Annaest/legWheel_Robot/solidworks/总装.SLDASM

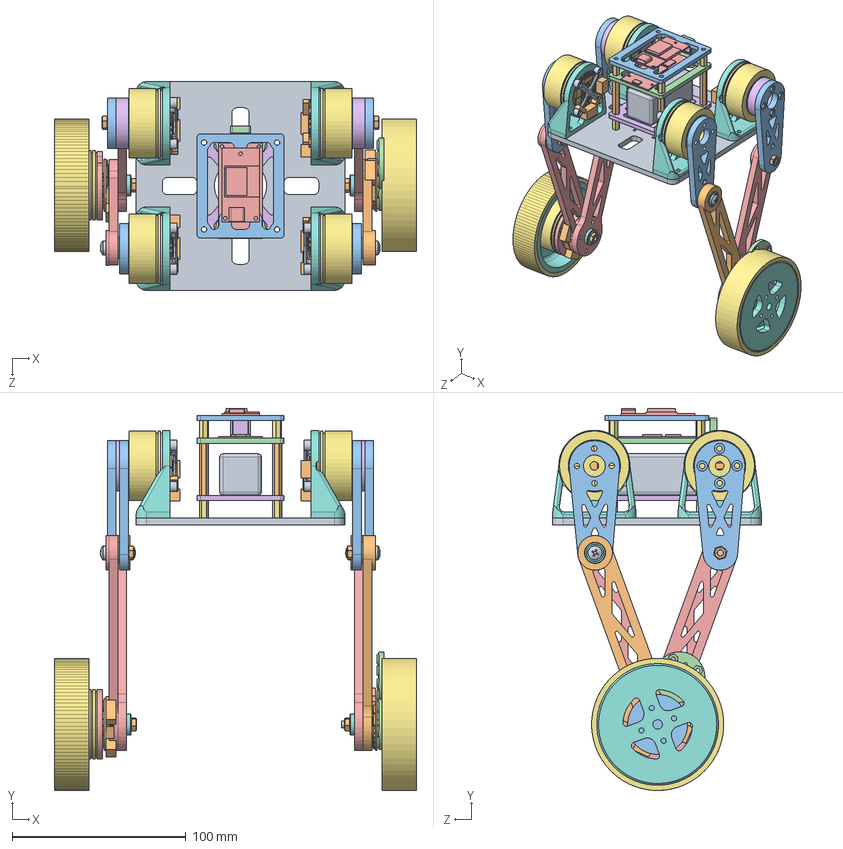
[picture p11: CAD file, 2024-07-02]
solidworks/总装.SLDASM
208.2 x 219.6 x 120.0 mm
底板
驱动板 x 6
大腿 x 4
推力轴承 x 6
小腿 x 3
大腿垫高 x 2
MISUMI_C-SE604ZZ_不锈钢小径滚珠轴承 x 6
cross recessed pan head screws gb x 4
hex nuts, style 1-grades ab gb x 6
编码器磁铁
MISUMI_CBSTSR4-16_内六角螺栓（盖螺栓）
主控板PCB
电池架
电池支撑铜柱 x 8
车轮 x 2
动力锂电池
主控支撑铜柱 x 4
主控支架
NanoPi支架
NanoPi
OV5640镜头
ME4010 x 5
关节电机支架-改 x 4
关节PCB紧固 x 3
小腿1
2805垫圈
轮胎 x 2
