Annaest/legWheel_Robot/solidworks/打印件/NanoPi支架.STL

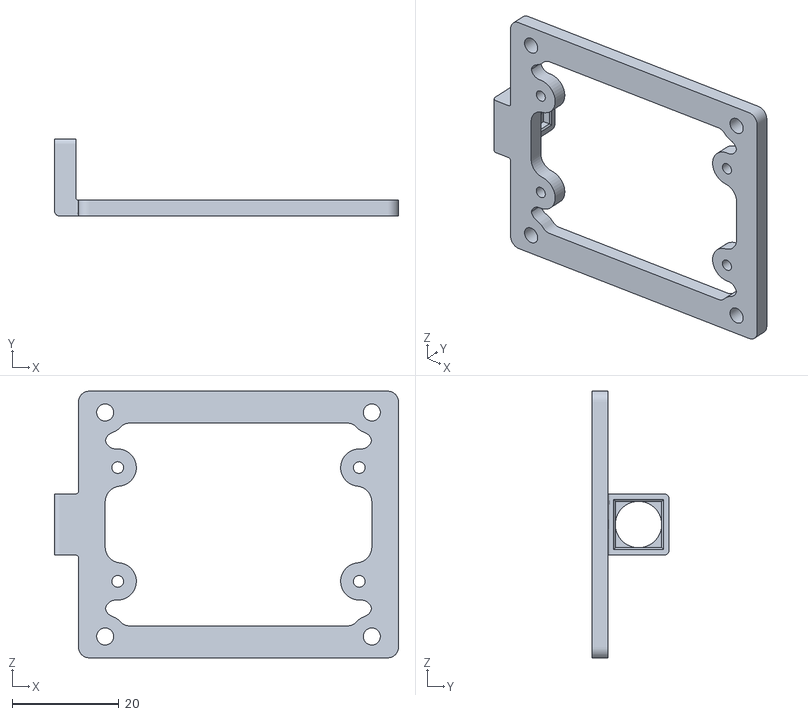
[picture p12: CAD file, 2024-07-02]
solidworks/打印件/NanoPi支架.STL
64.5 x 14.5 x 50.0
