Annaest/legWheel_Robot/solidworks/打印件3.30/2805垫圈-组合.SLDPRT

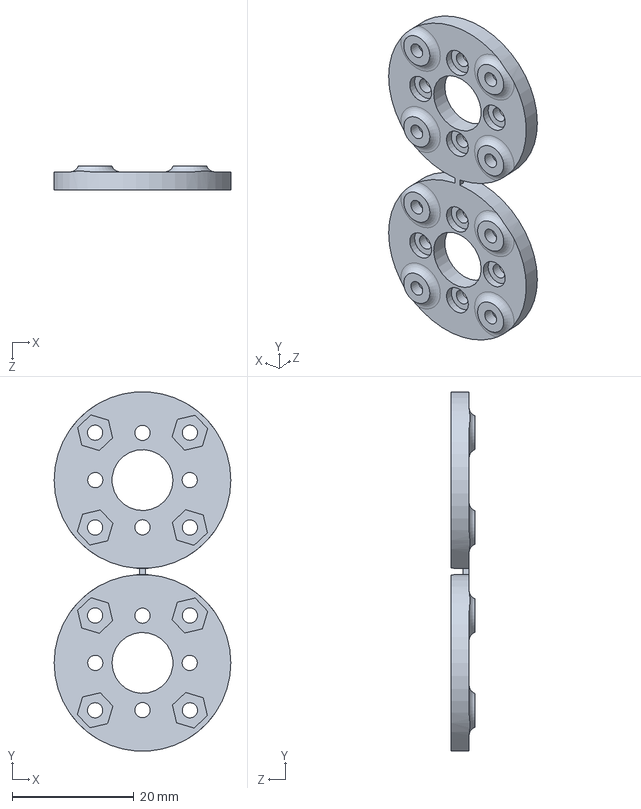
[picture p13: CAD file, 2024-07-02]
solidworks/打印件3.30/2805垫圈-组合.SLDPRT
29.0 x 58.9 x 4.00 mm
