Annaest/legWheel_Robot/solidworks/打印件4.3/车轮.STL

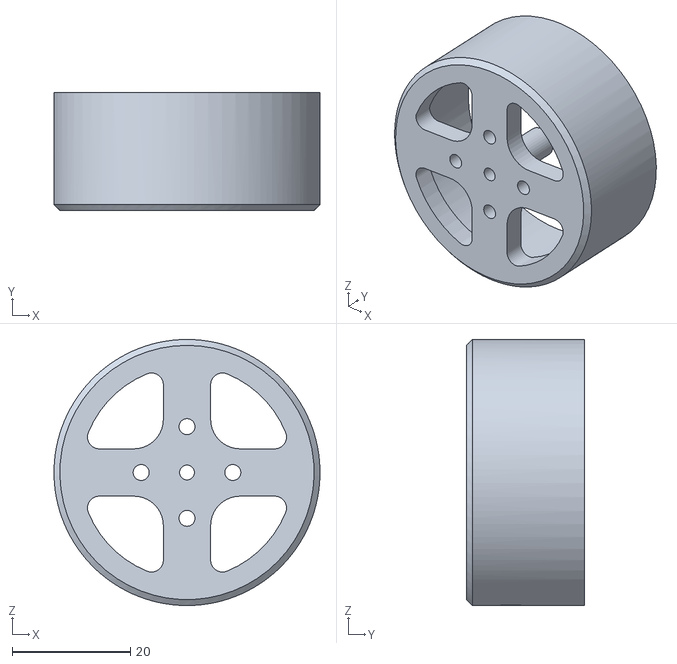
[picture p14: CAD file, 2024-07-02]
solidworks/打印件4.3/车轮.STL
45.0 x 20.0 x 45.0
