Annaest/legWheel_Robot/solidworks/打印件5.28/2805垫圈.STL

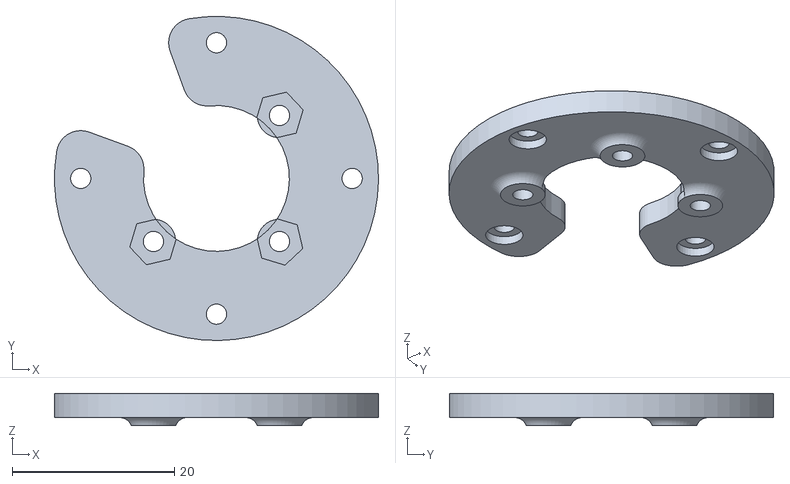
[picture p15: CAD file, 2024-07-02]
solidworks/打印件5.28/2805垫圈.STL
40.0 x 40.0 x 4.00
