Annaest/legWheel_Robot/solidworks/打印机5.16/关节电机支架-改.STL

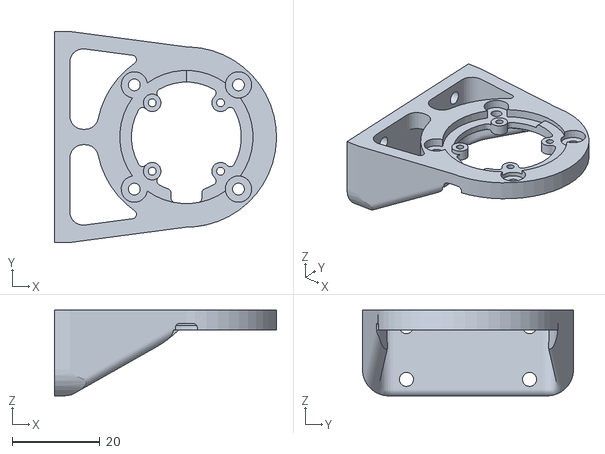
[picture p17: CAD file, 2024-07-02]
solidworks/打印机5.16/关节电机支架-改.STL
50.5 x 48.0 x 19.5
