Annaest/legWheel_Robot/solidworks/大腿.SLDPRT

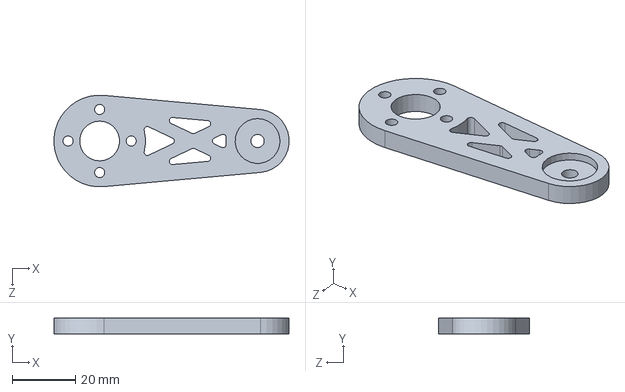
[picture p18: CAD file, 2024-07-02]
solidworks/大腿.SLDPRT
74.4 x 5.00 x 28.9 mm
