Annaest/legWheel_Robot/solidworks/打印件/车轮.STL

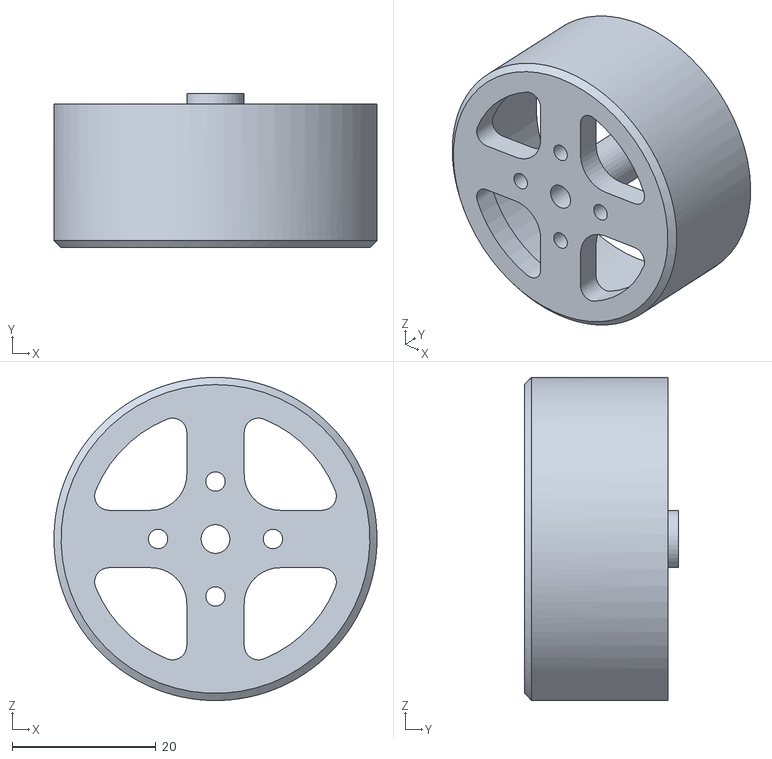
[picture p19: CAD file, 2024-07-02]
solidworks/打印件/车轮.STL
45.0 x 21.5 x 45.0
