Annaest/legWheel_Robot/solidworks/打印件3.30/车轮.SLDPRT

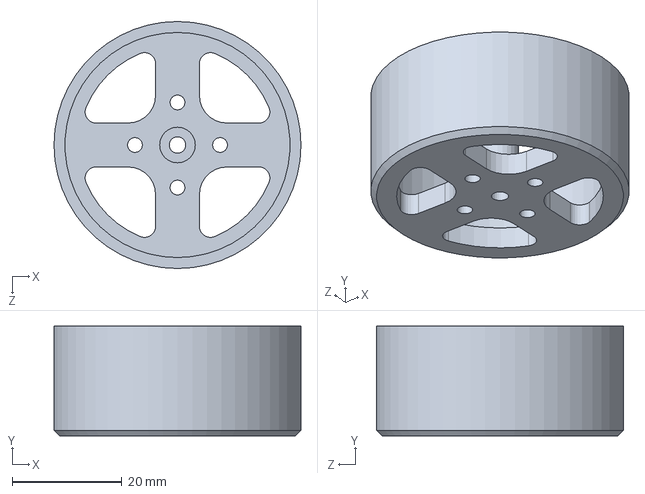
[picture p20: CAD file, 2024-07-02]
solidworks/打印件3.30/车轮.SLDPRT
45.0 x 20.0 x 45.0 mm
