Annaest/legWheel_Robot/solidworks/打印件5.28/车轮.STL

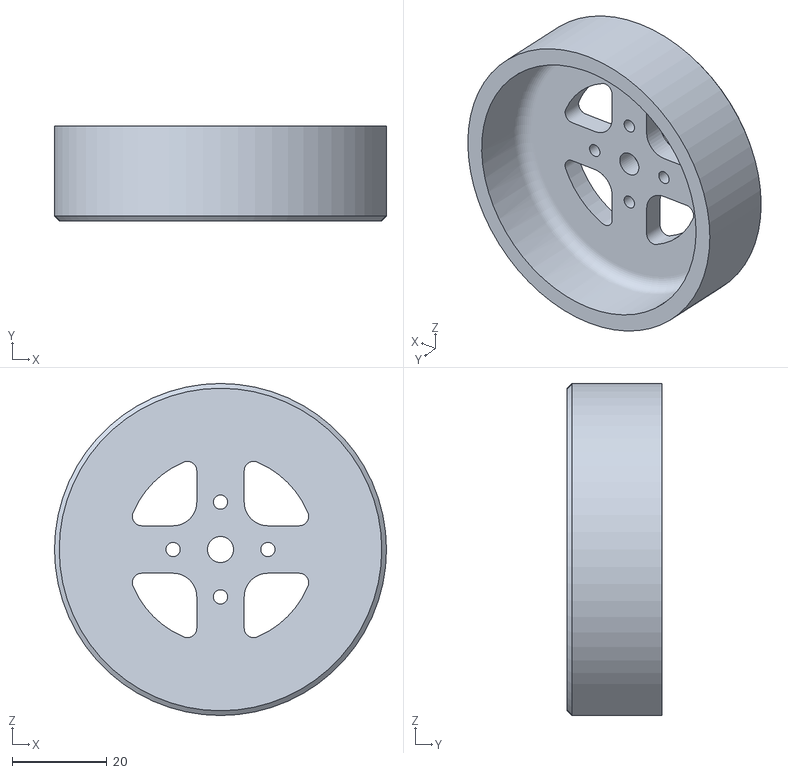
[picture p21: CAD file, 2024-07-02]
solidworks/打印件5.28/车轮.STL
70.0 x 20.0 x 70.0
