Annaest/legWheel_Robot/solidworks/打印机3.20/关节PCB紧固.STL

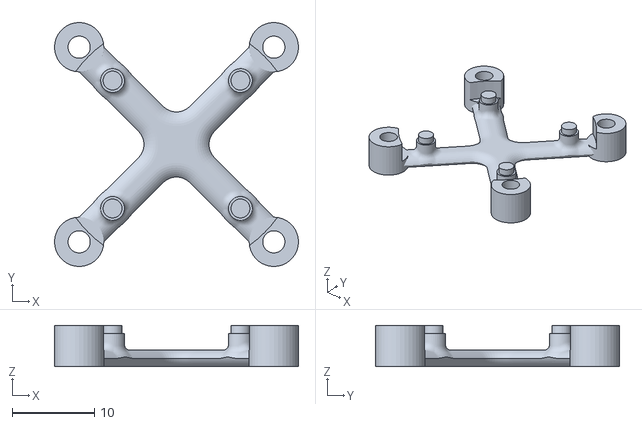
[picture p22: CAD file, 2024-07-02]
solidworks/打印机3.20/关节PCB紧固.STL
29.7 x 29.7 x 5.00
