Annaest/legWheel_Robot/solidworks/主控支架.SLDPRT

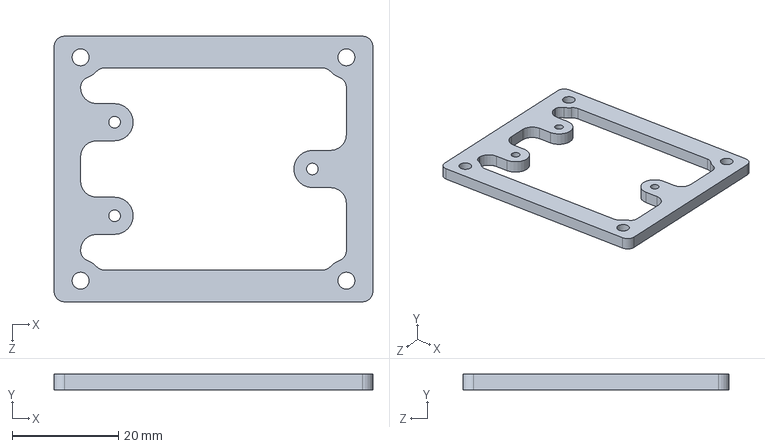
[picture p23: CAD file, 2024-07-02]
solidworks/主控支架.SLDPRT
60.0 x 3.00 x 50.0 mm
