Annaest/legWheel_Robot/solidworks/打印件/大腿垫高.STL

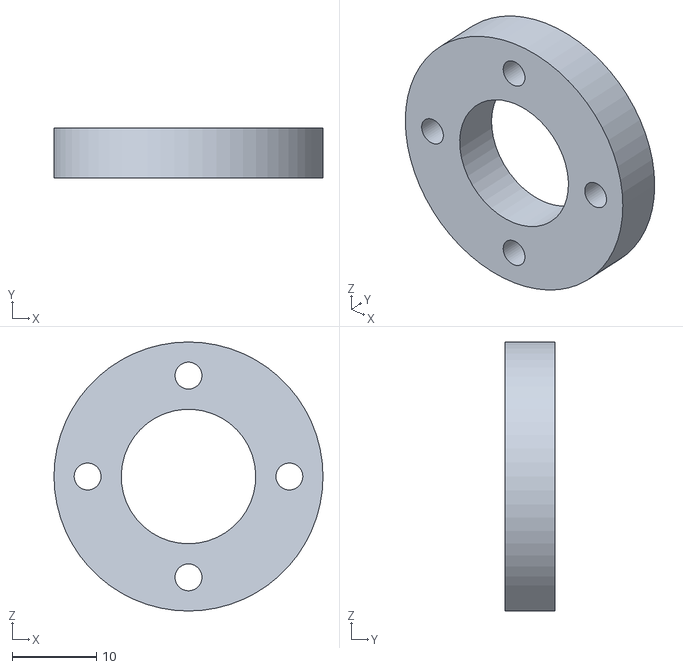
[picture p24: CAD file, 2024-07-02]
solidworks/打印件/大腿垫高.STL
32.0 x 6.00 x 32.0
