Annaest/legWheel_Robot/solidworks/打印机3.20/2805垫圈.STL

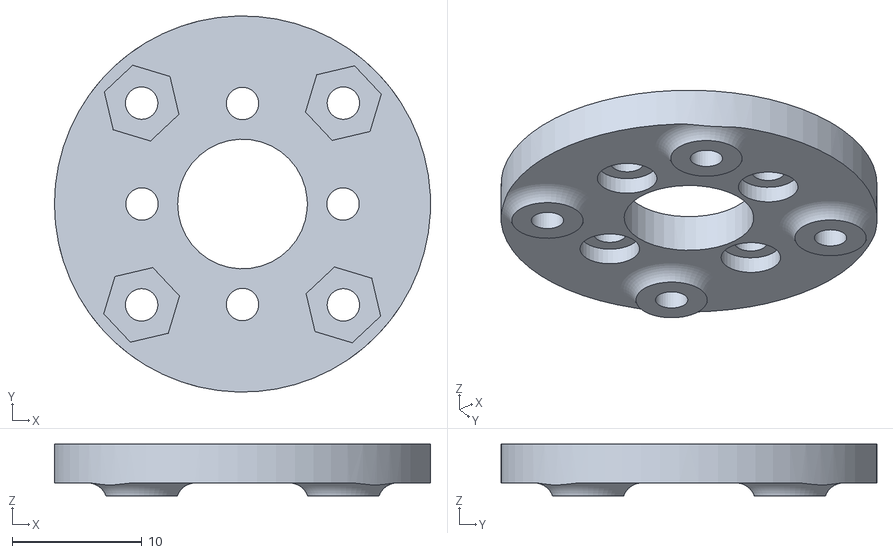
[picture p25: CAD file, 2024-07-02]
solidworks/打印机3.20/2805垫圈.STL
29.0 x 29.0 x 4.00
