Annaest/legWheel_Robot/solidworks/打印件/大腿.STL

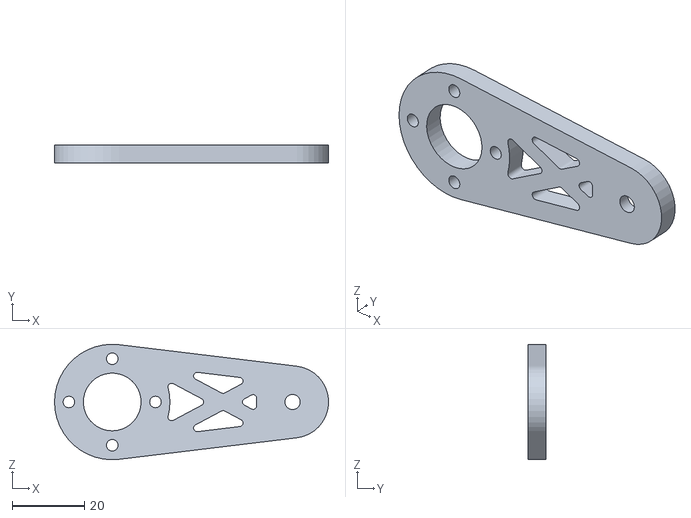
[picture p26: CAD file, 2024-07-02]
solidworks/打印件/大腿.STL
76.0 x 5.00 x 32.0
