Annaest/legWheel_Robot/solidworks/打印机3.20/大腿垫高.STL

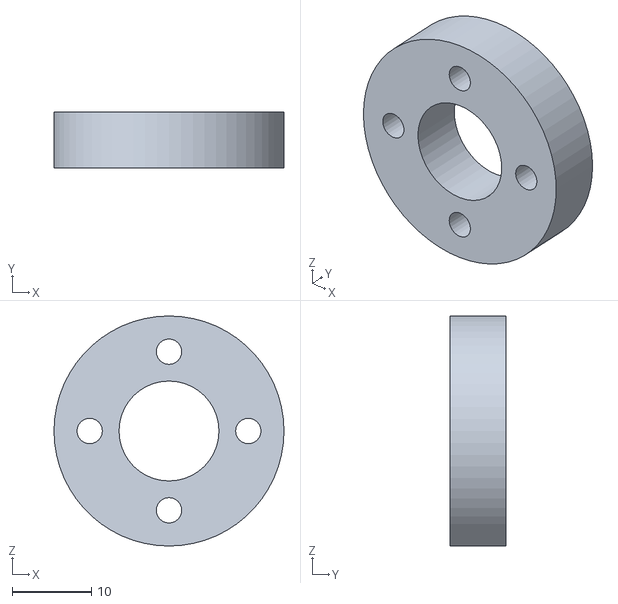
[picture p27: CAD file, 2024-07-02]
solidworks/打印机3.20/大腿垫高.STL
29.0 x 7.00 x 29.0
