Annaest/legWheel_Robot/solidworks/编码器磁铁.SLDPRT

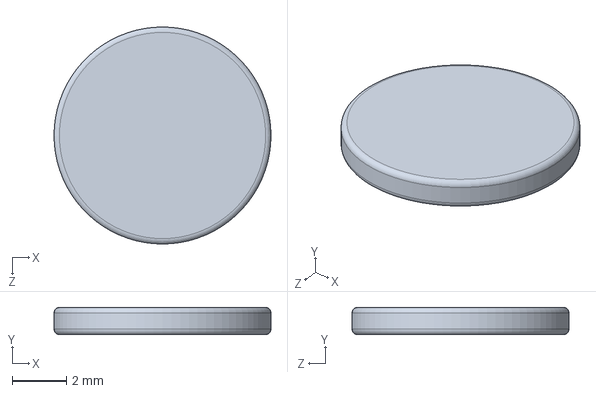
[picture p28: CAD file, 2024-07-02]
solidworks/编码器磁铁.SLDPRT
8.00 x 1.00 x 8.00 mm
