Annaest/legWheel_Robot/solidworks/动力锂电池.SLDPRT

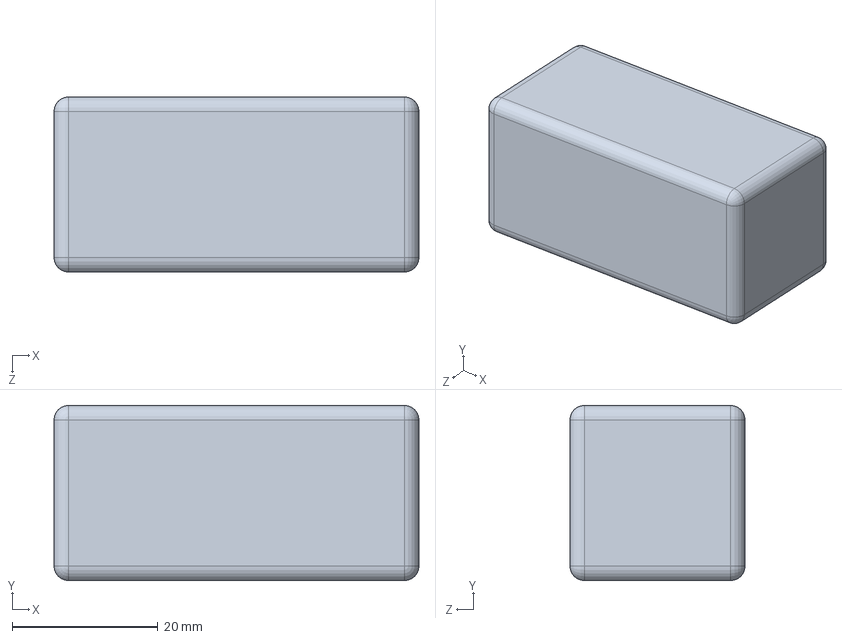
[picture p29: CAD file, 2024-07-02]
solidworks/动力锂电池.SLDPRT
50.0 x 24.0 x 24.0 mm
