Annaest/legWheel_Robot/solidworks/打印件/电池架.STL

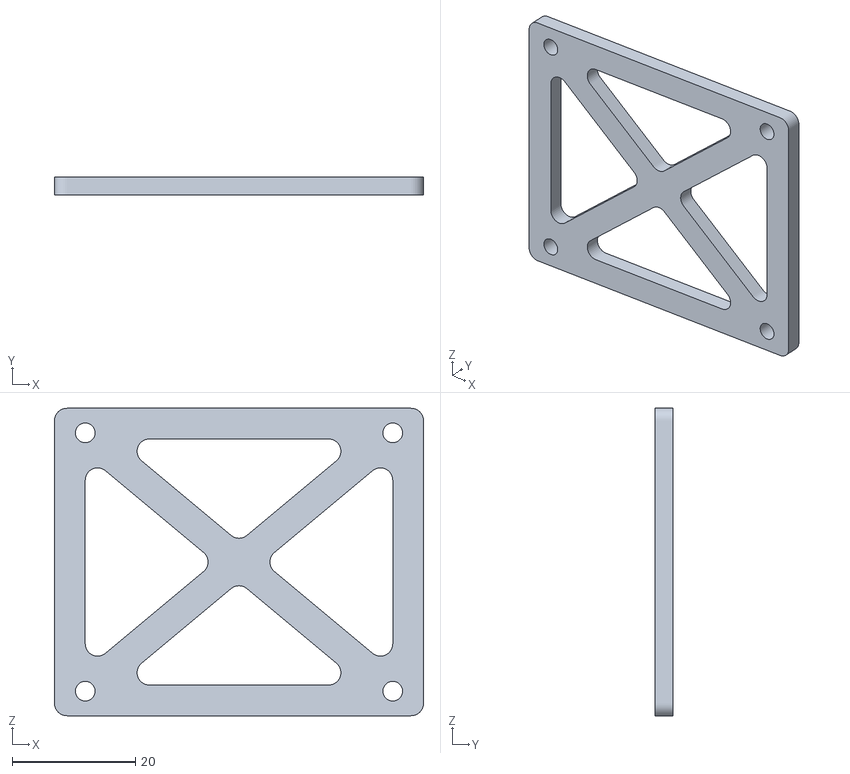
[picture p30: CAD file, 2024-07-02]
solidworks/打印件/电池架.STL
60.0 x 3.00 x 50.0
