Annaest/legWheel_Robot/solidworks/底板.SLDPRT

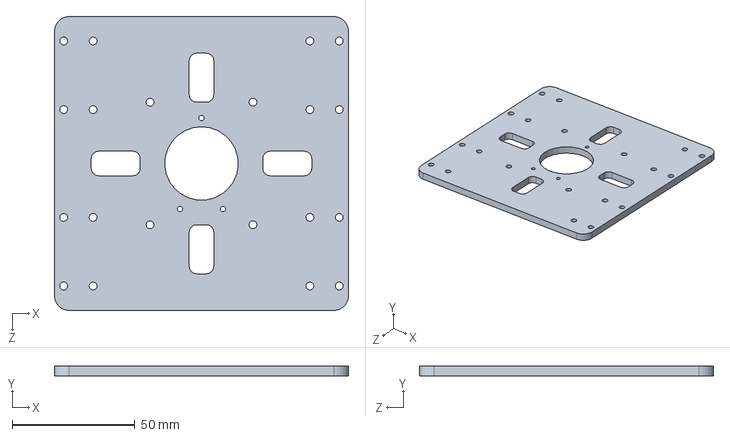
[picture p31: CAD file, 2024-07-02]
solidworks/底板.SLDPRT
120.0 x 4.00 x 120.0 mm
