Annaest/legWheel_Robot/solidworks/打印件/关节电机支架.STL

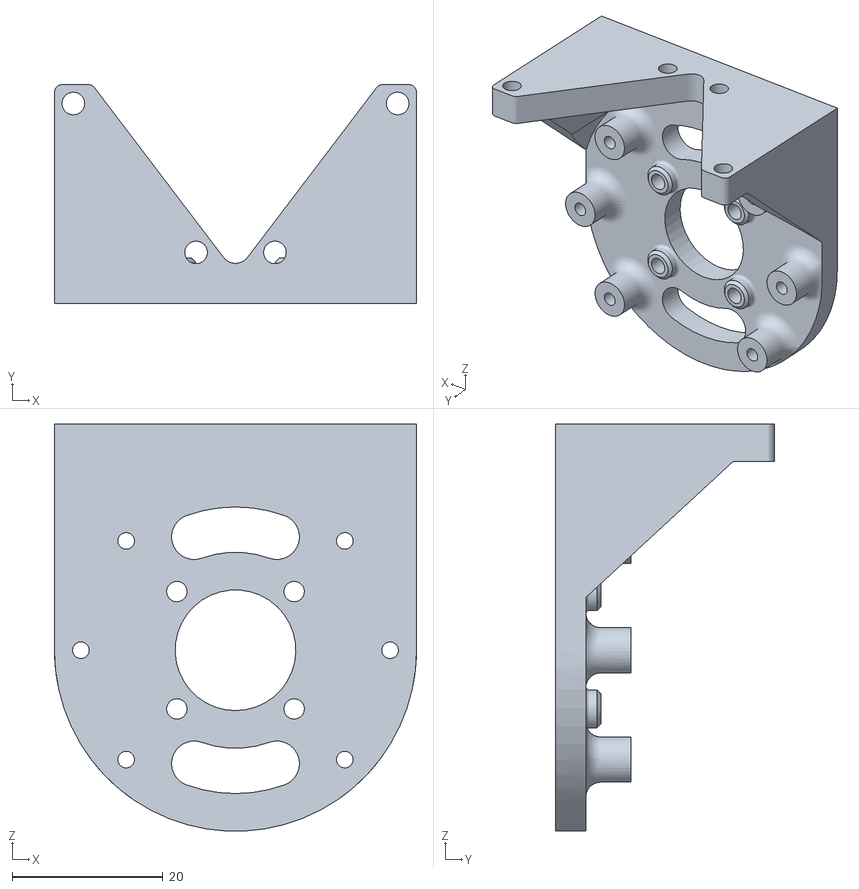
[picture p32: CAD file, 2024-07-02]
solidworks/打印件/关节电机支架.STL
48.0 x 29.0 x 54.0
