Annaest/legWheel_Robot/solidworks/小腿1.SLDPRT

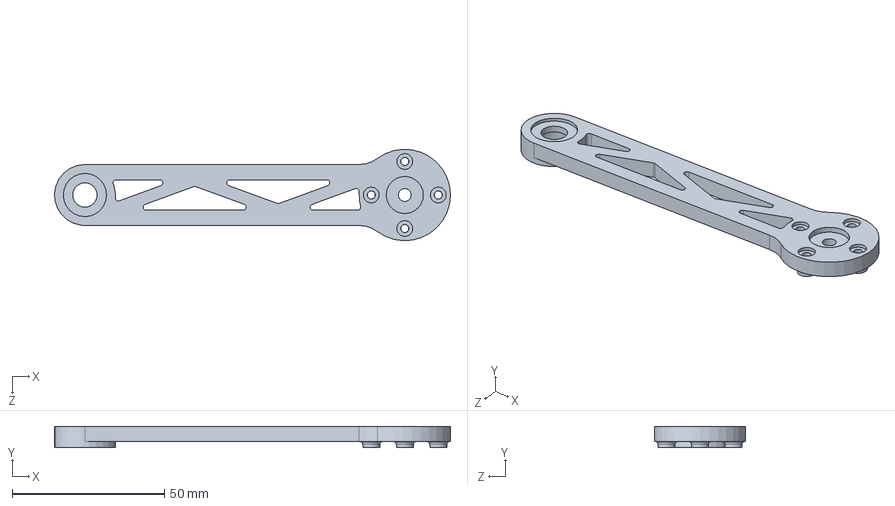
[picture p33: CAD file, 2024-07-02]
solidworks/小腿1.SLDPRT
130.0 x 7.00 x 30.0 mm
