Annaest/legWheel_Robot/solidworks/打印件/小腿.STL

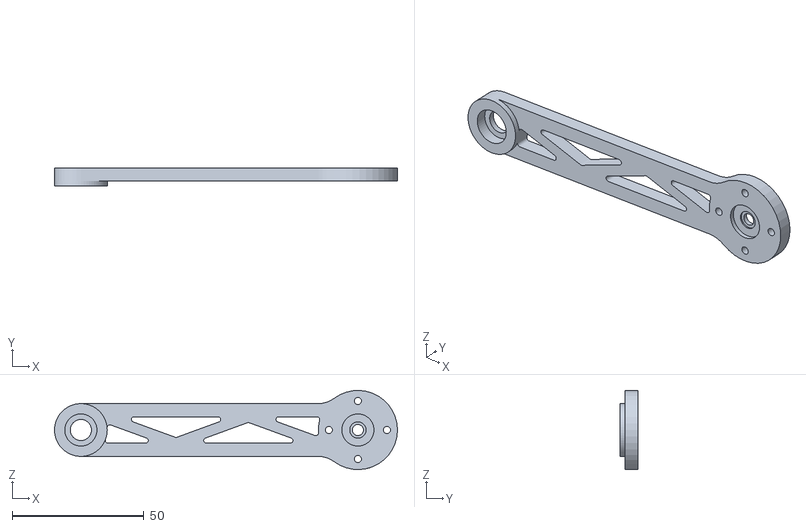
[picture p34: CAD file, 2024-07-02]
solidworks/打印件/小腿.STL
130.0 x 7.00 x 30.0
