Annaest/legWheel_Robot/solidworks/打印机3.20/小腿1.STL

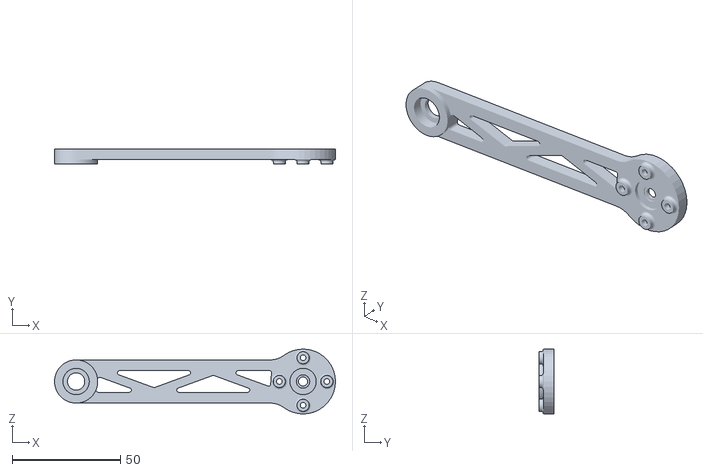
[picture p35: CAD file, 2024-07-02]
solidworks/打印机3.20/小腿1.STL
130.0 x 7.00 x 30.0
