Annaest/legWheel_Robot/solidworks/主控支撑铜柱.SLDPRT

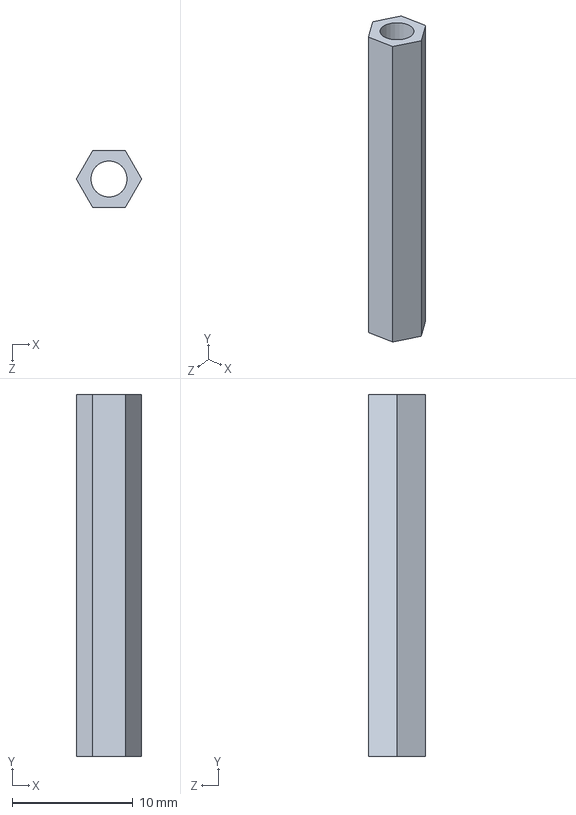
[picture p36: CAD file, 2024-07-02]
solidworks/主控支撑铜柱.SLDPRT
5.43 x 30.0 x 4.70 mm
