Annaest/legWheel_Robot/solidworks/电池支撑铜柱.SLDPRT

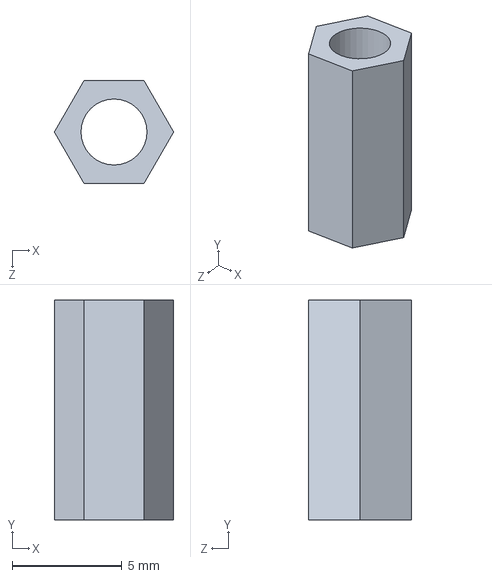
[picture p37: CAD file, 2024-07-02]
solidworks/电池支撑铜柱.SLDPRT
5.43 x 10.0 x 4.70 mm
