Annaest/legWheel_Robot/solidworks/ME4010.SLDPRT

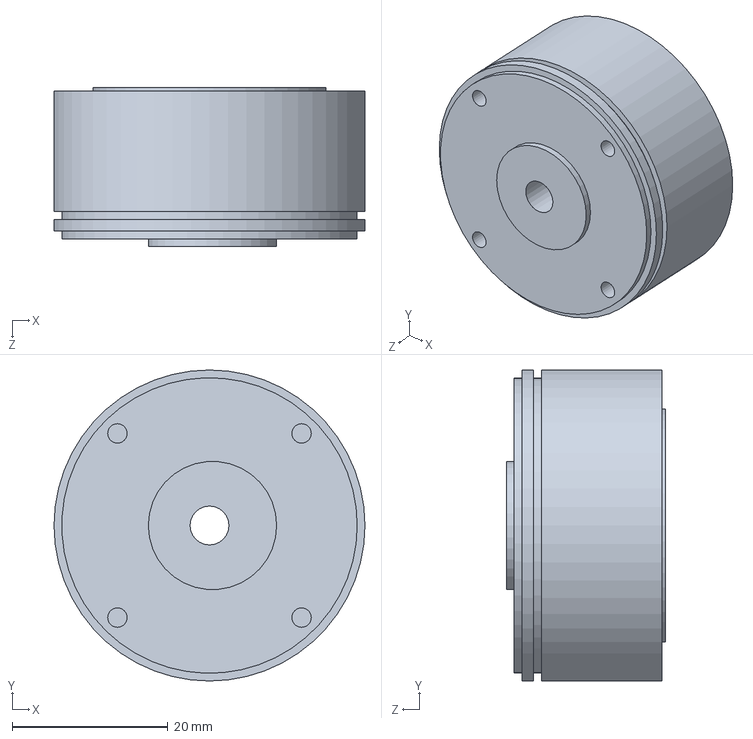
[picture p38: CAD file, 2024-07-02]
solidworks/ME4010.SLDPRT
40.0 x 40.0 x 20.5 mm
