Annaest/legWheel_Robot/solidworks/推力轴承.SLDPRT

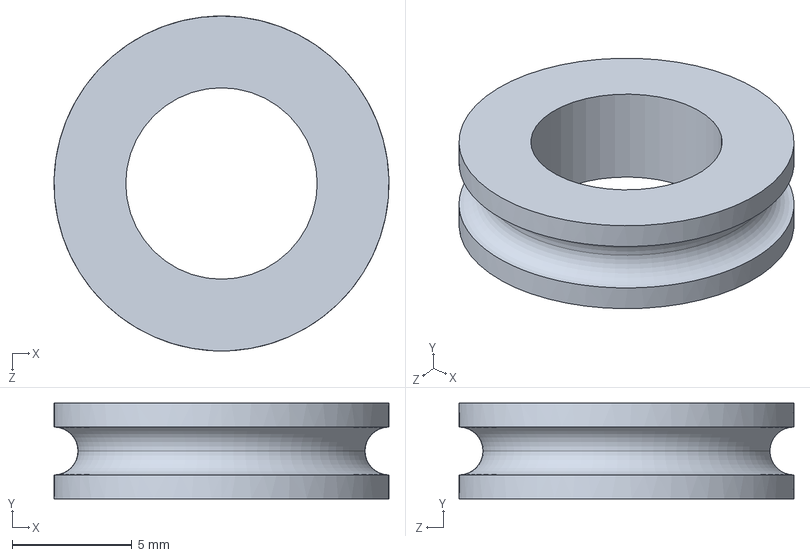
[picture p39: CAD file, 2024-07-02]
solidworks/推力轴承.SLDPRT
14.0 x 4.00 x 14.0 mm
