Annaest/legWheel_Robot/solidworks/4010电机.SLDPRT

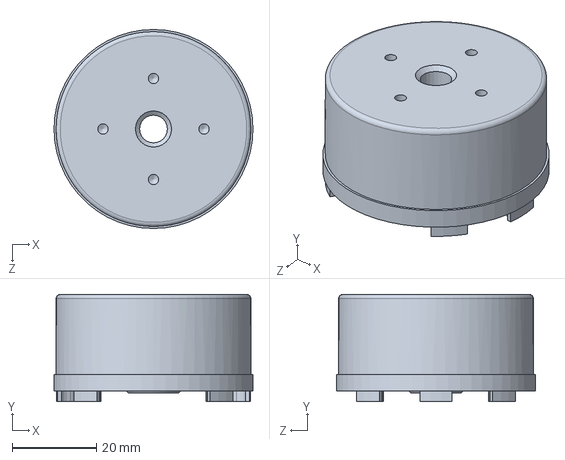
[picture p40: CAD file, 2024-07-02]
solidworks/4010电机.SLDPRT
47.3 x 25.5 x 47.3 mm
