Annaest/legWheel_Robot/solidworks/铜柱M2-3-3.SLDPRT

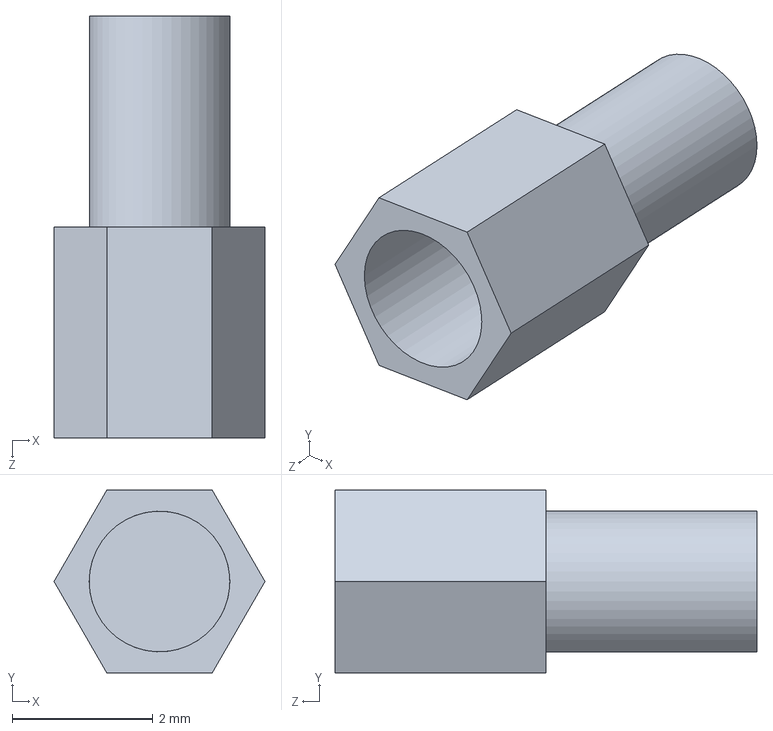
[picture p41: CAD file, 2024-07-02]
solidworks/铜柱M2-3-3.SLDPRT
3.00 x 2.60 x 6.00 mm
