Annaest/legWheel_Robot/solidworks/主控板PCB.SLDPRT

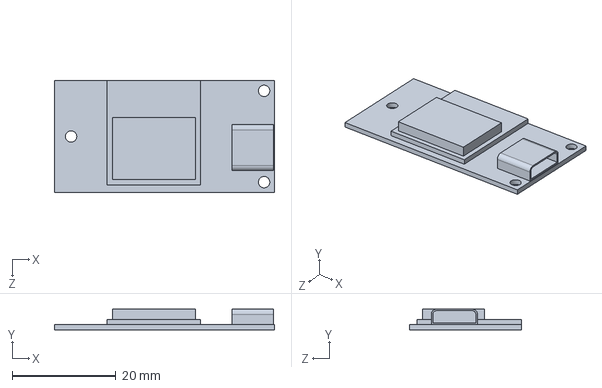
[picture p42: CAD file, 2024-07-02]
solidworks/主控板PCB.SLDPRT
42.4 x 4.00 x 21.6 mm
