Annaest/legWheel_Robot/solidworks/2805.SLDPRT

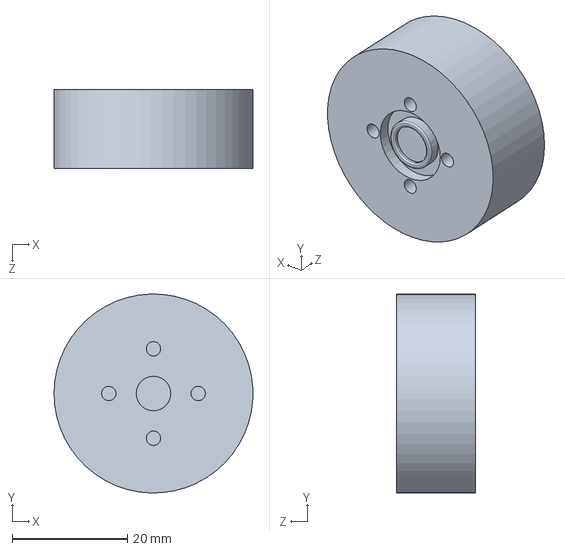
[picture p43: CAD file, 2024-07-02]
solidworks/2805.SLDPRT
34.5 x 34.5 x 13.7 mm
