Annaest/legWheel_Robot/solidworks/OV5640镜头.SLDPRT

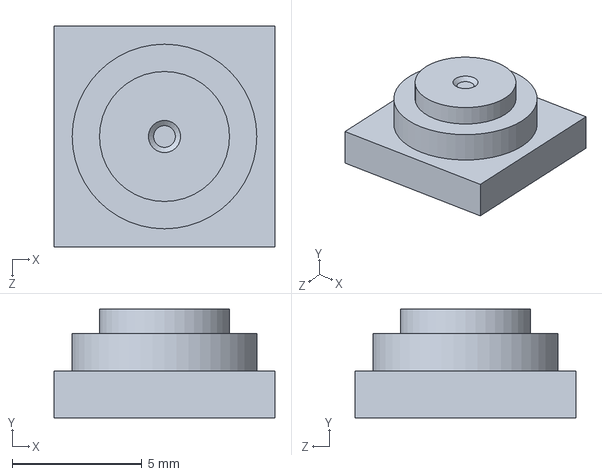
[picture p44: CAD file, 2024-07-02]
solidworks/OV5640镜头.SLDPRT
8.50 x 4.19 x 8.50 mm
