Annaest/legWheel_Robot/solidworks/hex nuts, style 1-grades ab gb.sldprt

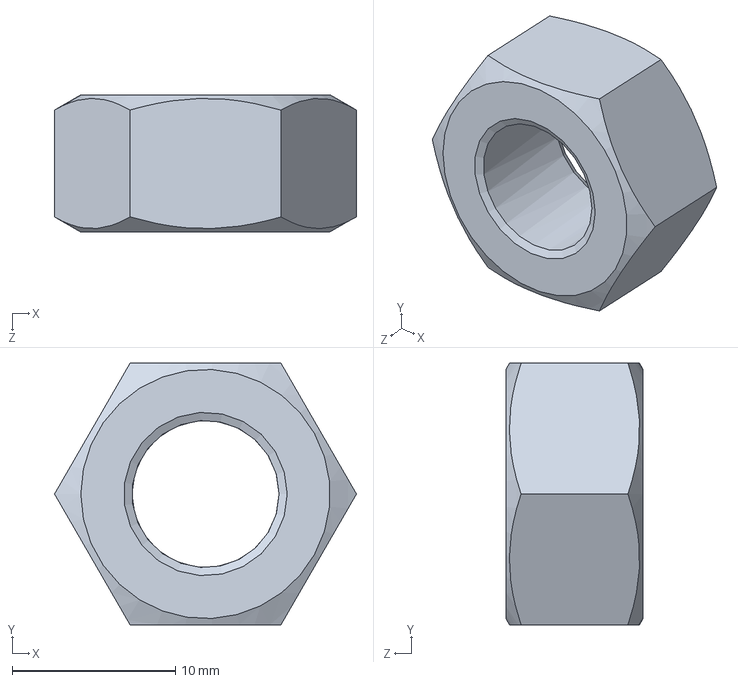
[picture p45: CAD file, 2024-07-02]
solidworks/hex nuts, style 1-grades ab gb.sldprt
18.5 x 16.0 x 8.40 mm
