Annaest/legWheel_Robot/solidworks/2804电机.SLDPRT

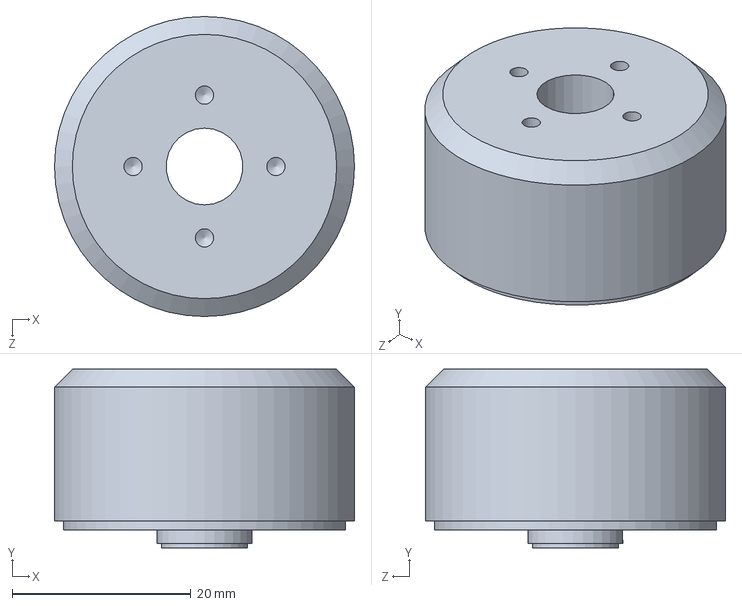
[picture p46: CAD file, 2024-07-02]
solidworks/2804电机.SLDPRT
33.6 x 20.0 x 33.6 mm
