Annaest/legWheel_Robot/solidworks/铜柱M2-3-4.SLDPRT

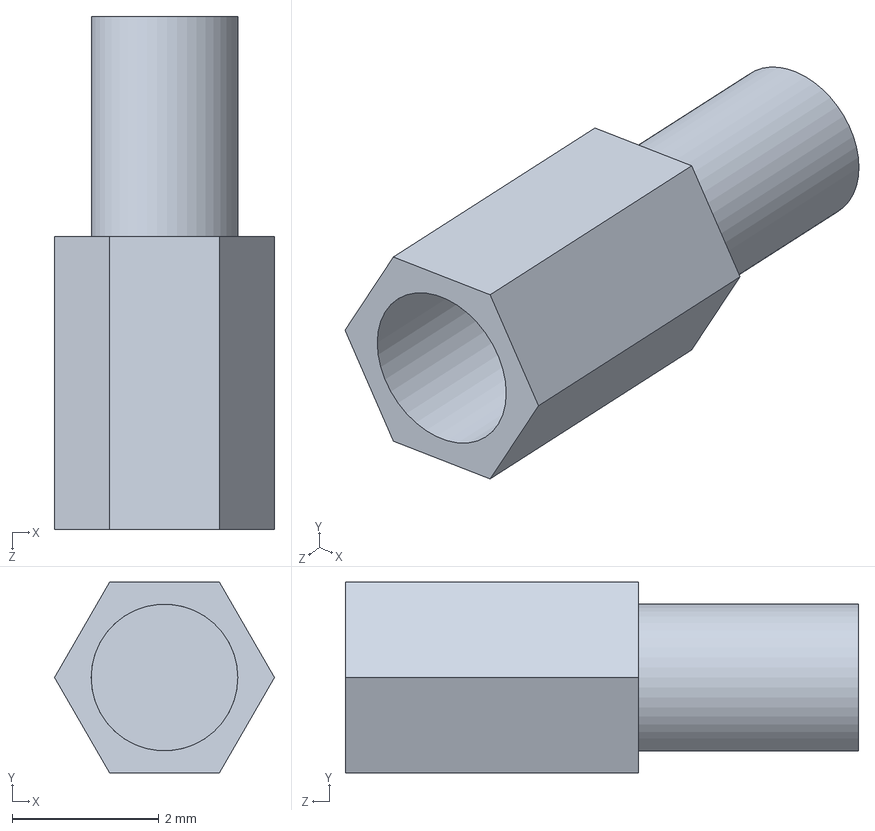
[picture p47: CAD file, 2024-07-02]
solidworks/铜柱M2-3-4.SLDPRT
3.00 x 2.60 x 7.00 mm
