Annaest/legWheel_Robot/solidworks/NanoPi.SLDPRT

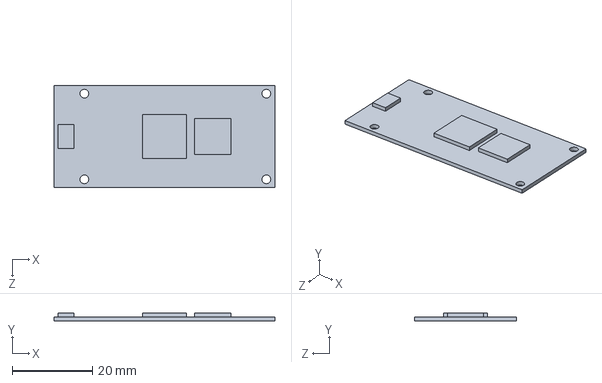
[picture p48: CAD file, 2024-07-02]
solidworks/NanoPi.SLDPRT
55.0 x 2.00 x 25.4 mm
