Annaest/legWheel_Robot/solidworks/轮胎.SLDPRT

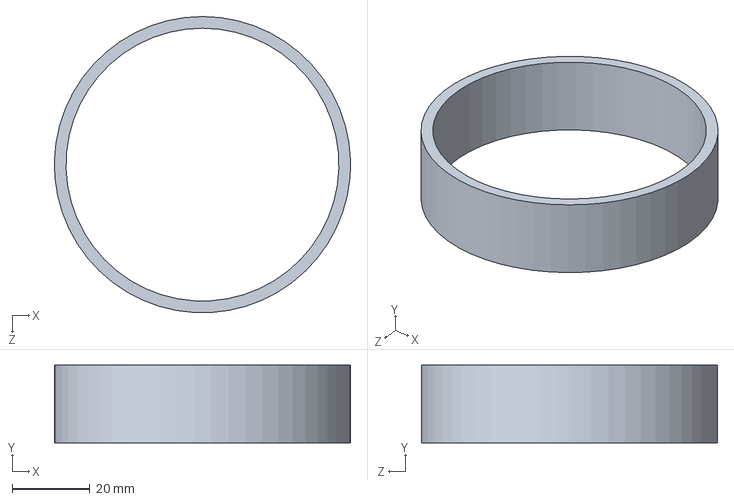
[picture p49: CAD file, 2024-07-02]
solidworks/轮胎.SLDPRT
76.0 x 20.0 x 75.9 mm
