Annaest/legWheel_Robot/solidworks/驱动板.SLDPRT

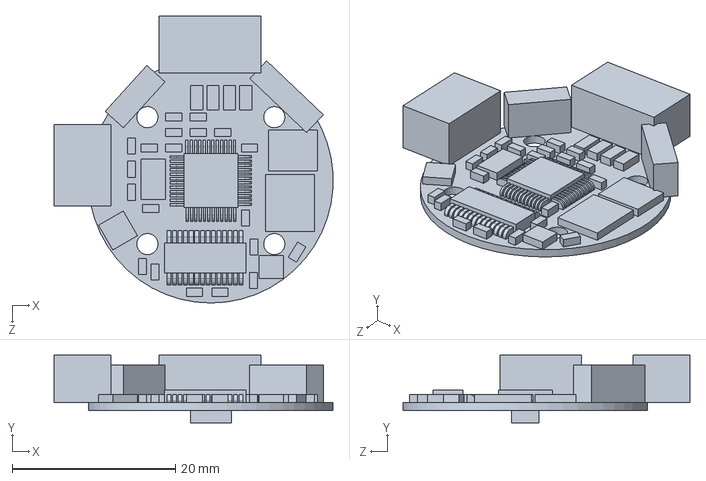
[picture p50: CAD file, 2024-07-02]
solidworks/驱动板.SLDPRT
34.2 x 8.30 x 35.2 mm
