Annaest/legWheel_Robot/(list of files, cad)

Other CAD files:
solidworks/打印件4.3/关节电机支架-改.STL
solidworks/打印机3.20/大腿.STL
solidworks/打印机3.20/底板.DWG
solidworks/打印件/主控支架.STL
solidworks/2805垫圈.SLDPRT
solidworks/关节电机支架-改.SLDPRT
solidworks/电池架.SLDPRT
solidworks/NanoPi支架.SLDPRT
solidworks/小腿.SLDPRT
solidworks/大腿垫高.SLDPRT
solidworks/关节PCB紧固.SLDPRT
solidworks/车轮.SLDPRT
solidworks/关节电机支架.SLDPRT
solidworks/4010电机 - 副本.SLDPRT
solidworks/MISUMI_C-SE604ZZ_不锈钢小径滚珠轴承.SLDPRT
solidworks/MISUMI_CBSTSR4-16_内六角螺栓（盖螺栓）.SLDPRT
solidworks/cross recessed pan head screws gb.sldprt
solidworks/关节电机支架 - 副本.SLDPRT
solidworks/大腿 - 副本.SLDPRT
solidworks/大腿垫高 - 副本.SLDPRT
solidworks/底板 - 副本.SLDPRT
solidworks/底板.DWG
solidworks/底板.DXF
solidworks/总装 - 副本.SLDASM
solidworks/打印件3.30/2805垫圈-组合.STL
