Annaest/legWheel_Robot/(list of files, drawings)

Other design files:
esp32_hardware/ESP32CTRL_AD_PCB.pcbdoc
esp32_hardware/ESP32CTRL_AD_SCH.schdoc
stm32-foc/hardware/STM32FOC_AD_PCB.pcbdoc
stm32-foc/hardware/STM32FOC_AD_PCB/STM32FOC_AD_PCB.pcbdoc
stm32-foc/hardware/STM32FOC_AD_SCH.schdoc
