Annaest/legWheel_Robot/stm32-foc/software/USER/BLDCMotor.c

/************************************************
本文件主要来自CSDN博主loop222对SimpleFOC项目的移植
原教程：https://blog.csdn.net/loop222/article/details/120471390
本项目删除了部分代码，添加了Flash数据读取和对蜂鸣功能的兼容
************************************************/

#include "BLDCmotor.h"
#include "FOCMotor.h"
#include "foc_utils.h"
#include "gpio.h"
#include <stdio.h>
#include "MagneticSensor.h" 
#include "tim.h"
#include "FlashStorage.h"

#define M1_Enable HAL_GPIO_WritePin(GPIOA,GPIO_PIN_4,GPIO_PIN_SET)
#define M1_Disable HAL_GPIO_WritePin(GPIOA,GPIO_PIN_4,GPIO_PIN_RESET)
#define PWM_Period 1280

extern float target;

long sensor_direction;
float voltage_power_supply;
float voltage_limit;
float voltage_sensor_align;
int  pole_pairs;
unsigned long open_loop_timestamp;
float velocity_limit;
uint8_t start_flag = 0;

int alignSensor(void);
float velocityOpenloop(float target_velocity);
float angleOpenloop(float target_angle);
/******************************************************************************/
void Motor_init(void)
{
	printf("MOT: Init\r\n");
	
	if(voltage_sensor_align > voltage_limit)
		voltage_sensor_align = voltage_limit;
	
	pole_pairs=7;
	sensor_direction=UNKNOWN;
	M1_Enable;
	printf("MOT: Enable driver.\r\n");
}
/******************************************************************************/
void Motor_initFOC(void)
{
	if(Flash_ReadMotorParam(&pole_pairs, &zero_electric_angle, (int*)&sensor_direction) == -1) //尝试读取Flash数据
	{
		if(alignSensor()) //读取识别则进行电机校准，检测零点偏移量和极对数
			Flash_SaveMotorParam(pole_pairs, zero_electric_angle, sensor_direction); //校准数据存入Flash
	}
	
	//added the shaft_angle update
	angle_prev=getAngle();  //getVelocity(),make sure velocity=0 after power on
	HAL_Delay(5);
	shaft_angle = shaftAngle();// shaft angle
	
	HAL_Delay(200);
}
/******************************************************************************/
int alignSensor(void)
{
	long i;
	float angle;
	float mid_angle,end_angle;
	float moved;
	
	printf("MOT: Align sensor.\r\n");
	
	// find natural direction
	// move one electrical revolution forward
	for(i=0; i<=500; i++)
	{
		angle = _3PI_2 + _2PI * i / 500.0;
		setPhaseVoltage(voltage_sensor_align, 0,  angle);
		HAL_Delay(2);
	}
	mid_angle=getAngle();
	
	for(i=500; i>=0; i--) 
	{
		angle = _3PI_2 + _2PI * i / 500.0 ;
		setPhaseVoltage(voltage_sensor_align, 0,  angle);
		HAL_Delay(2);
	}
	end_angle=getAngle();
	setPhaseVoltage(0, 0, 0);
	HAL_Delay(200);
	
	printf("mid_angle=%.4f\r\n",mid_angle);
	printf("end_angle=%.4f\r\n",end_angle);
	
	moved =  fabs(mid_angle - end_angle);
	if((mid_angle == end_angle)||(moved < 0.02))  //相等或者几乎没有动
	{
		printf("MOT: Failed to notice movement loop222.\r\n");
		M1_Disable;    //电机检测不正常，关闭驱动
		return 0;
	}
	else if(mid_angle < end_angle)
	{
		printf("MOT: sensor_direction==CCW\r\n");
		sensor_direction=CCW;
	}
	else
	{
		printf("MOT: sensor_direction==CW\r\n");
		sensor_direction=CW;
	}
	
	
	printf("MOT: PP check: ");    //计算Pole_Pairs
	if( fabs(moved*pole_pairs - _2PI) > 0.5 )  // 0.5 is arbitrary number it can be lower or higher!
	{
		printf("fail - estimated pp:");
		pole_pairs=_2PI/moved+0.5;     //浮点数转整形，四舍五入
		printf("%d\r\n",pole_pairs);
  }
	else
		printf("OK!\r\n");
	
	
	setPhaseVoltage(voltage_sensor_align, 0,  _3PI_2);  //计算零点偏移角度
	HAL_Delay(700);
	zero_electric_angle = _normalizeAngle(_electricalAngle(sensor_direction*getAngle(), pole_pairs));
	HAL_Delay(20);
	printf("MOT: Zero elec. angle:");
	printf("%.4f\r\n",zero_electric_angle);
	
	setPhaseVoltage(0, 0, 0);
	HAL_Delay(200);
	
	return 1;
}

/** 位置PID，关节电机位置 **/
void Motor_SetPosition(float target, float now_pos)
{
	if(start_flag == 0) return;
	//if(fabs(target) > _2PI) return;
	float kp = 50;
	float ki = 0.0001;
	float kd = 25;
	float pid_out = 0;
	float real_pos = now_pos;
//	if(target  >= _2PI)      target -= _2PI;
//	else if(target  < -_2PI)  target += _2PI;
	// if(now_pos >= 0)      now_pos = fmod(now_pos, _2PI);
	// else if(now_pos < 0)  now_pos = -fmod(now_pos, -_2PI);
	float error = (int)((target - now_pos)*100)/100.0;
	static float p_error = 0;
	static float I = 0;
	float KI = 0;
	if(fabs(_2PI - fabs(target - real_pos)) >= fabs(target - real_pos))
		error = target - real_pos;
	else{
		error = -error/fabs(error) * (_2PI - fabs(target - real_pos));
	}
	
	I += error;
	KI = ki * I;
	KI = KI > 12 ? 12 : KI;
	KI = KI < -12 ? -12 : KI;
	pid_out = kp * error + KI + kd * (error - p_error);
	p_error = error;
	pid_out = pid_out > 12? 12 : pid_out;
	pid_out = pid_out < -12? -12 : pid_out;
	setTargetVotage((int)(pid_out*10)/10.0);
}

/** 增量pid，足部电机速度闭环 **/
void Motor_SetVelocity(float velocity)
{
	if(start_flag == 0) return;
	velocity = 4;
	//if(fabs(target) > _2PI) return;
	float kp = 0;
	float ki = 1000;
	float kd = 0;
	static float pid_out = 0;
	float error = 0;
	static float error_p = 0;
	static float error_pp = 0;
	if(speed >= 0)
		error = -velocity + speed*(6/36.5);
	else if(speed < 0)
	 	error = -velocity + speed*(6/56.0);
	pid_out = kp *(error_p - error) + ki * error + kd * (error - 2 * error_p + error_pp);
	error_pp = error_p;   
	error_p = error;

	float targetV = (int)((velocity + pid_out)*100) / 100.0;
	targetV = targetV > 7 ? 7 : targetV;
	targetV = targetV < -7 ? -7 : targetV;
	if(targetV < 0){
		targetV = targetV*0.55;
	}
	setTargetVotage(targetV); //设定FOC电压

}
/******************************************************************************/
void loopFOC(void)
{
	if( controller==Type_angle_openloop || controller==Type_velocity_openloop ) return;
	
	shaft_angle = shaftAngle();// shaft angle
	electrical_angle = electricalAngle();// electrical angle - need shaftAngle to be called first
	
	switch(torque_controller)
	{
		case Type_voltage:  // no need to do anything really
			break;
		case Type_dc_current:
			break;
		case Type_foc_current:
			break;
		default:
			printf("MOT: no torque control selected!");
			break;
	}
	if(motorID == 3 || motorID == 7){
		setTargetVotage(targetVotage);
	}
	else{
		Motor_SetPosition(targetPosition, shaft_angle);  //((int)(targetPosition*100))/100.f
	}

	setPhaseVoltage(voltage.q, voltage.d, electrical_angle);
}
/******************************************************************************/
void setTargetVotage(float new_target)
{
	voltage.q = new_target;
}
/******************************************************************************/
void setPhaseVoltage(float Uq, float Ud, float angle_el)
{
	float Uout;
	uint32_t sector;
	float T0,T1,T2;
	float Ta,Tb,Tc;
	
	if(Ud) // only if Ud and Uq set 
	{// _sqrt is an approx of sqrt (3-4% error)
		Uout = _sqrt(Ud*Ud + Uq*Uq) / voltage_power_supply;
		// angle normalisation in between 0 and 2pi
		// only necessary if using _sin and _cos - approximation functions
		angle_el = _normalizeAngle(angle_el + atan2(Uq, Ud));
	}
	else
	{// only Uq available - no need for atan2 and sqrt
		Uout = Uq / voltage_power_supply;
		// angle normalisation in between 0 and 2pi
		// only necessary if using _sin and _cos - approximation functions
		angle_el = _normalizeAngle(angle_el + _PI_2);
	}
	if(Uout> 0.577)Uout= 0.577;
	if(Uout<-0.577)Uout=-0.577;
	
	sector = (angle_el / _PI_3) + 1;
	T1 = _SQRT3*_sin(sector*_PI_3 - angle_el) * Uout;
	T2 = _SQRT3*_sin(angle_el - (sector-1.0)*_PI_3) * Uout;
	T0 = 1 - T1 - T2;
	
	// calculate the duty cycles(times)
	switch(sector)
	{
		case 1:
			Ta = T1 + T2 + T0/2;
			Tb = T2 + T0/2;
			Tc = T0/2;
			break;
		case 2:
			Ta = T1 +  T0/2;
			Tb = T1 + T2 + T0/2;
			Tc = T0/2;
			break;
		case 3:
			Ta = T0/2;
			Tb = T1 + T2 + T0/2;
			Tc = T2 + T0/2;
			break;
		case 4:
			Ta = T0/2;
			Tb = T1+ T0/2;
			Tc = T1 + T2 + T0/2;
			break;
		case 5:
			Ta = T2 + T0/2;
			Tb = T0/2;
			Tc = T1 + T2 + T0/2;
			break;
		case 6:
			Ta = T1 + T2 + T0/2;
			Tb = T0/2;
			Tc = T1 + T0/2;
			break;
		default:  // possible error state
			Ta = 0;
			Tb = 0;
			Tc = 0;
	}
	
	__HAL_TIM_SetCompare(&htim2,TIM_CHANNEL_1,Ta*PWM_Period);
	__HAL_TIM_SetCompare(&htim2,TIM_CHANNEL_2,Tb*PWM_Period);
	__HAL_TIM_SetCompare(&htim2,TIM_CHANNEL_3,Tc*PWM_Period);
}
