Annaest/legWheel_Robot/stm32-foc/software/C6T6SimpleFoc.ioc

Mcu.UserName=STM32F103C6Tx
PA0-WKUP.Signal=S_TIM2_CH1_ETR
PA1.Signal=S_TIM2_CH2
PA11.Signal=CAN_RX
PA12.Signal=CAN_TX
PA13.Signal=SYS_JTMS-SWDIO
PA14.Signal=SYS_JTCK-SWCLK
PA2.Signal=S_TIM2_CH3
PA3.Signal=GPIO_Input
PA4.Signal=GPIO_Output
PB6.Signal=GPIO_Output
PB7.Signal=GPIO_Output
PC13-TAMPER-RTC.Signal=GPIO_Output
