Annaest/legWheel_Robot/(commit log)

2024-07-02 upload foc and 3D-model
    [2804电机.SLDPRT, 2805.SLDPRT, 2805垫圈-组合.SLDPRT, 2805垫圈-组合.STL, 2805垫圈.SLDPRT, 2805垫圈.STL, 4010电机 - 副本.SLDPRT, 4010电机.SLDPRT]
2024-07-02 add esp32_hardworks
    [ESP32CTRL_AD_PCB.pcbdoc, ESP32CTRL_AD_SCH.schdoc]
